Gustav2/P7/cw308t_mspm0l2228/render_top.png

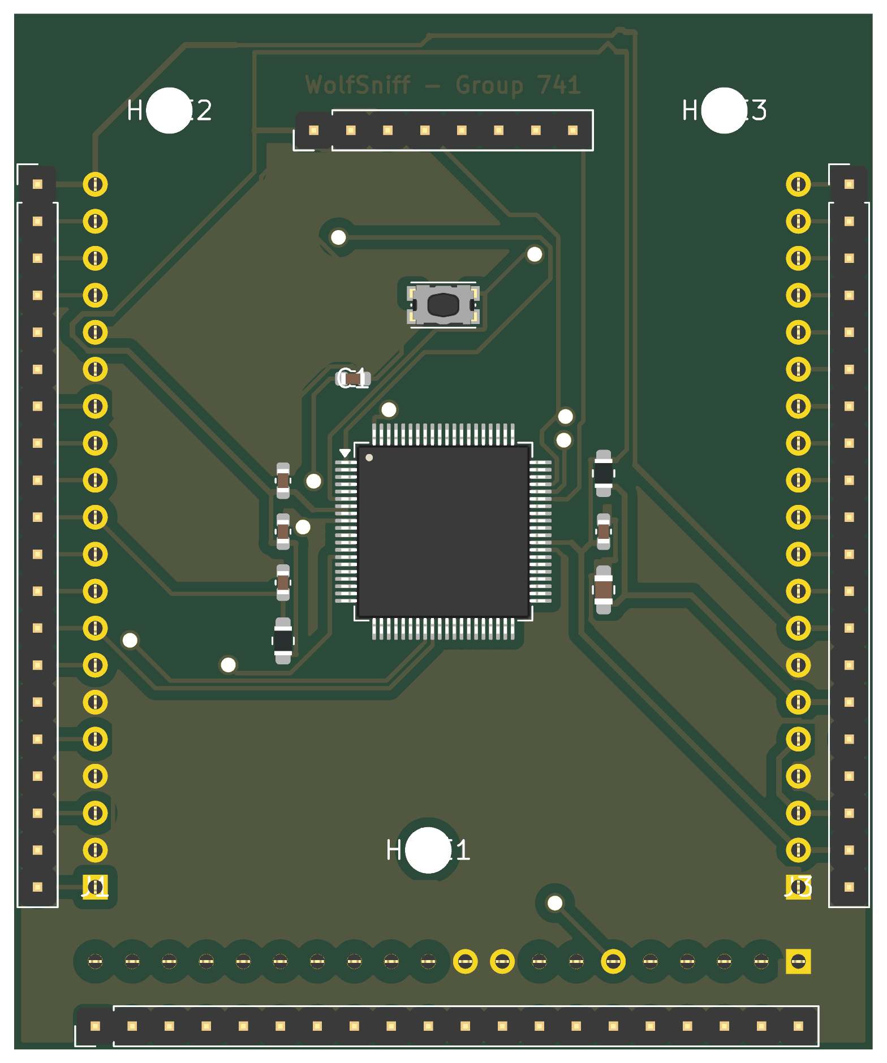
cw308t_mspm0l2228/render_top.png
