Gustav2/P7/cw308t_mspm0l2228/BOM.csv

Ref | Qty | Value | Footprint | Populate | Notes
U1 | 1 | MSPM0L2228SPN | LQFP-80 14x14 0.65mm | YES | Target MCU
C1 | 1 | 470nF | 0603 | YES | VCORE (pin 80) - required | hard against the pin
C2 | 1 | 100nF | 0603 | YES | VDD/VSS (pin 8/9)
C5 | 1 | 100nF | 0603 | YES | VBAT (pin 7)
C3 | 1 | 100nF | 0603 | YES | VDD2 (pin 49)
C4 | 1 | 4.7uF | 0805 | YES | Bulk (supply side of shunt)
C6 | 1 | 100nF | 0603 | NO (DNP) | Optional nRST cap
R1 | 1 | 0R | 0805 | NO (DNP) | Optional local shunt
R2 | 1 | 10k | 0805 | NO (DNP) | Optional nRST pull-up
J1/J3/J4 | 3 | PinSocket 1x20 2.54mm | female vertical (BOTTOM) | YES | CW308 West/East/South sockets - mate down onto adapter
P1/P3/P4 | 3 | PinHeader 1x20 2.54mm | male vertical (TOP) | YES | All-60 breakout headers (offset 0.1in) for cables
J_SWD | 1 | Cortex 2x5 1.27mm | PinHeader 2x05 | YES | SWD debug
SW1 | 1 | Reset | SW KMR2 SMD | YES | nRST button
TP_BSL | 1 | BSL | TestPoint 1.5mm | OPTIONAL | PA18 BSL test point
HOLE1-3 | 3 | M3 | 3.2mm | YES | Mounting (adapter positions)
