Gustav2/P7/cw308t_mspm0l2228/sch.pdf

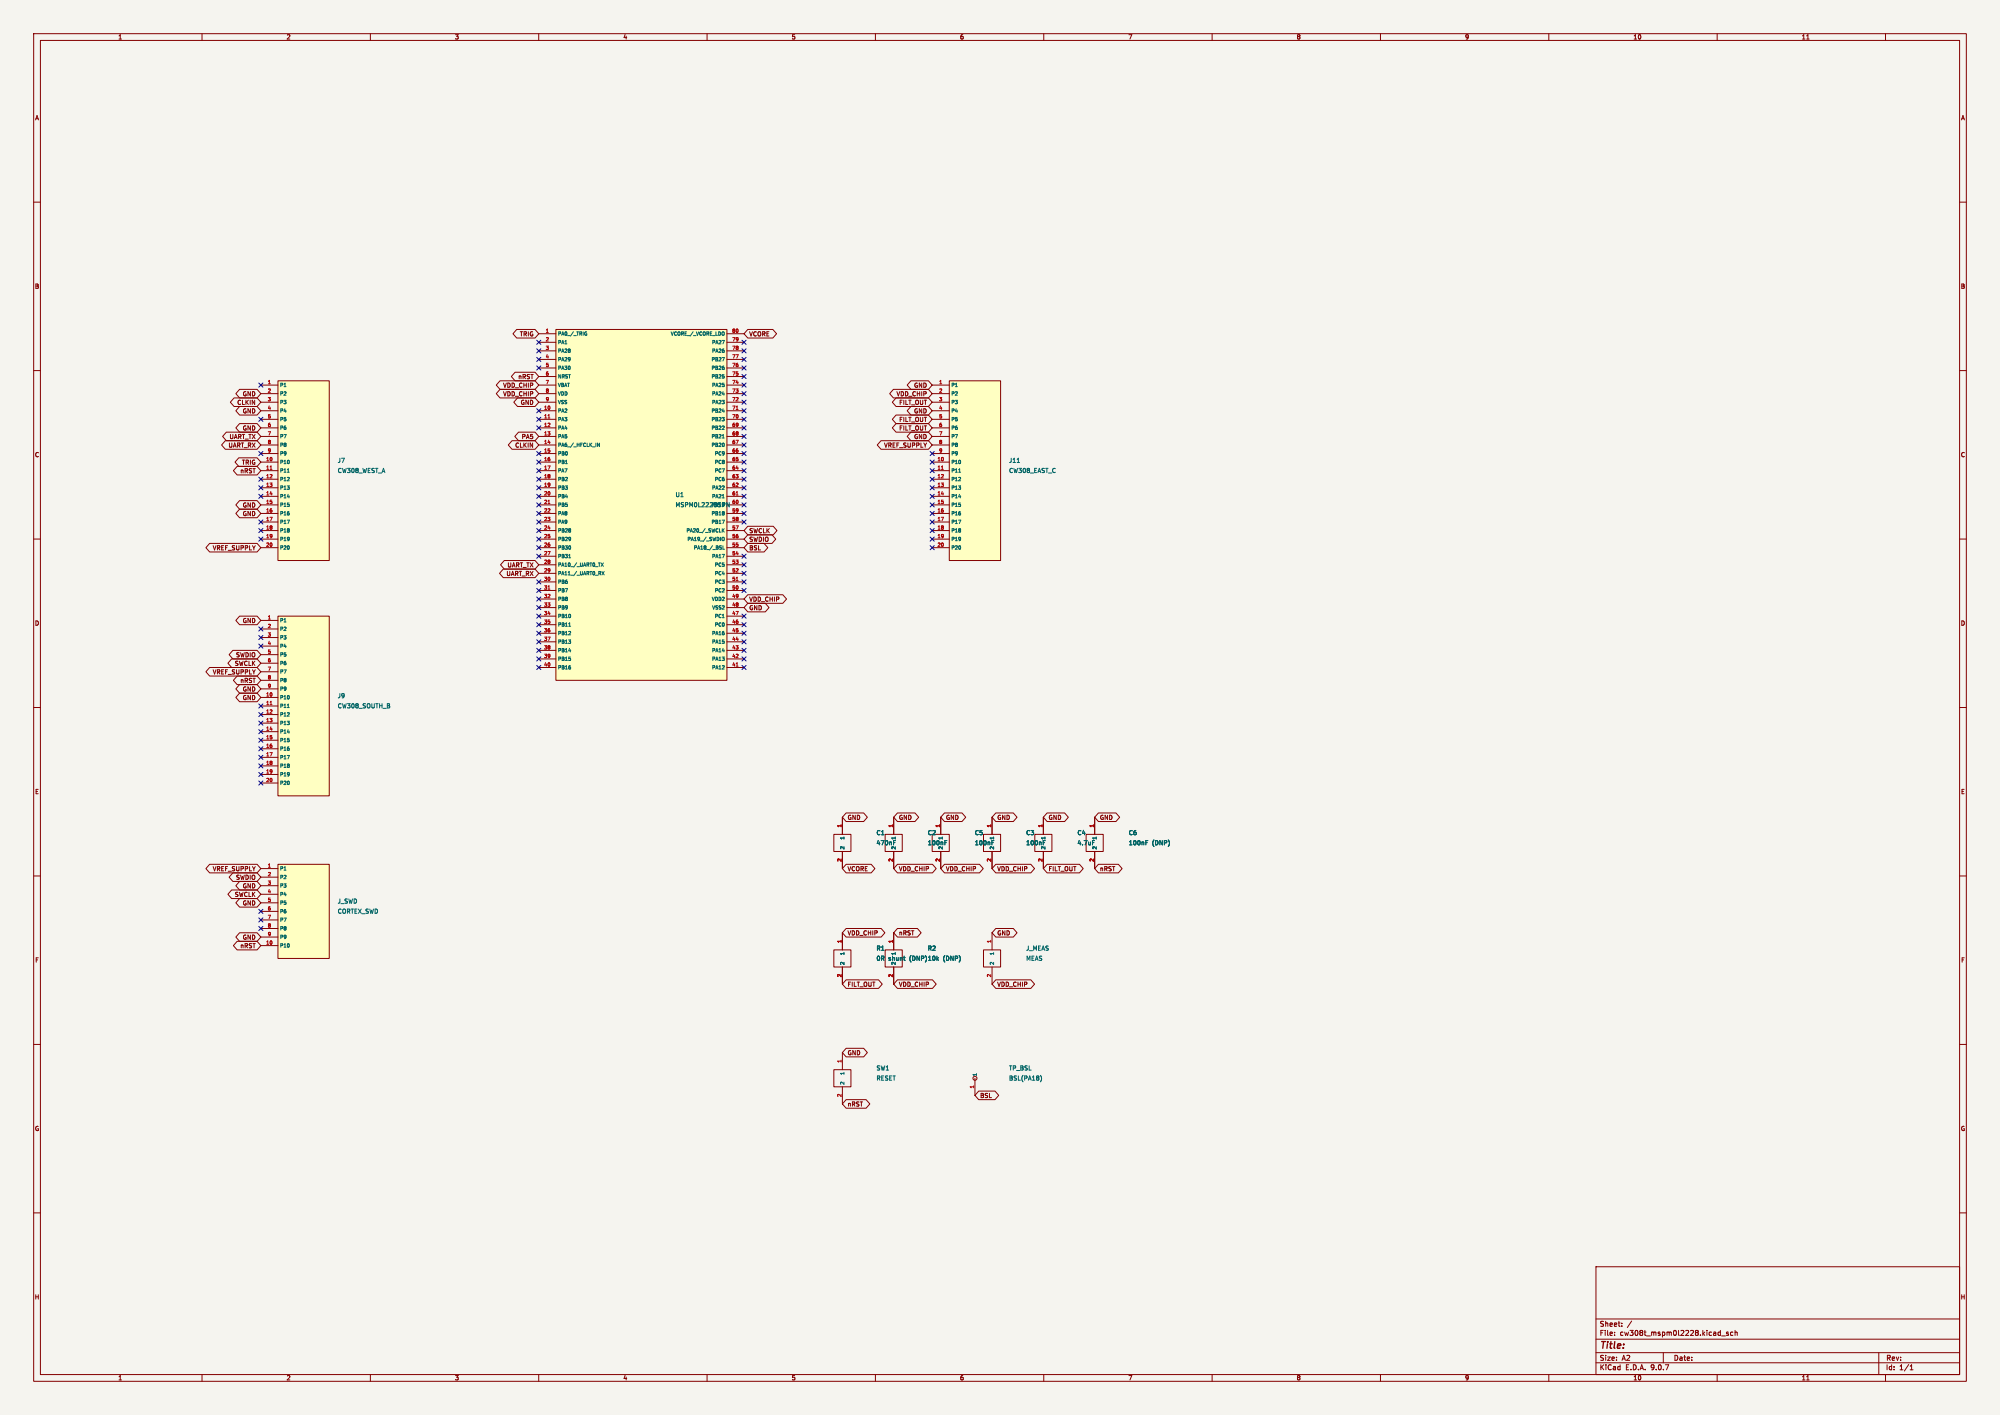
[picture p3: page 1]

CLKIN GND GND GND GND GND
nRST UART_RX UART_TX GND
