Gustav2/P7/cw308t_mspm0l2228/layout.pdf

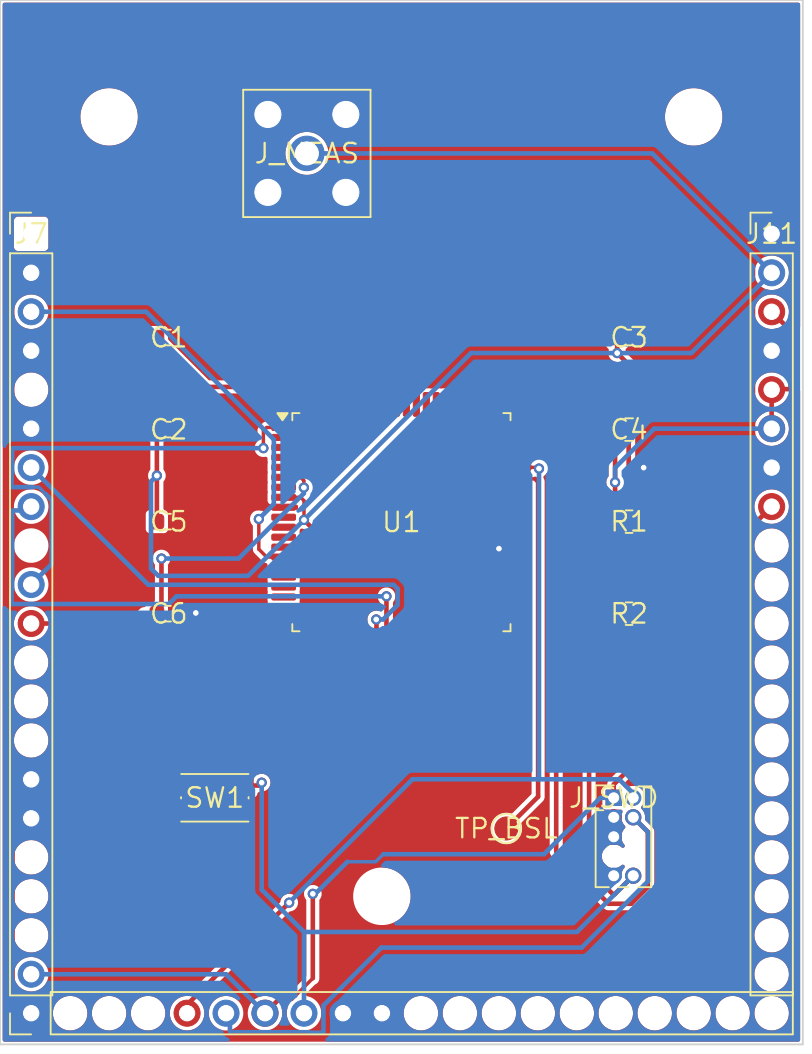
[picture p4: page 1]
