Gustav2/P7/(list of files, drawings)

Other design files:
cw308t_mspm0l2228/cw308t_mspm0l2228.dsn
