Gustav2/P7/pcb/pcb.kicad_pcb

## KiCad design pcb/pcb.kicad_pcb (2026-10-29)

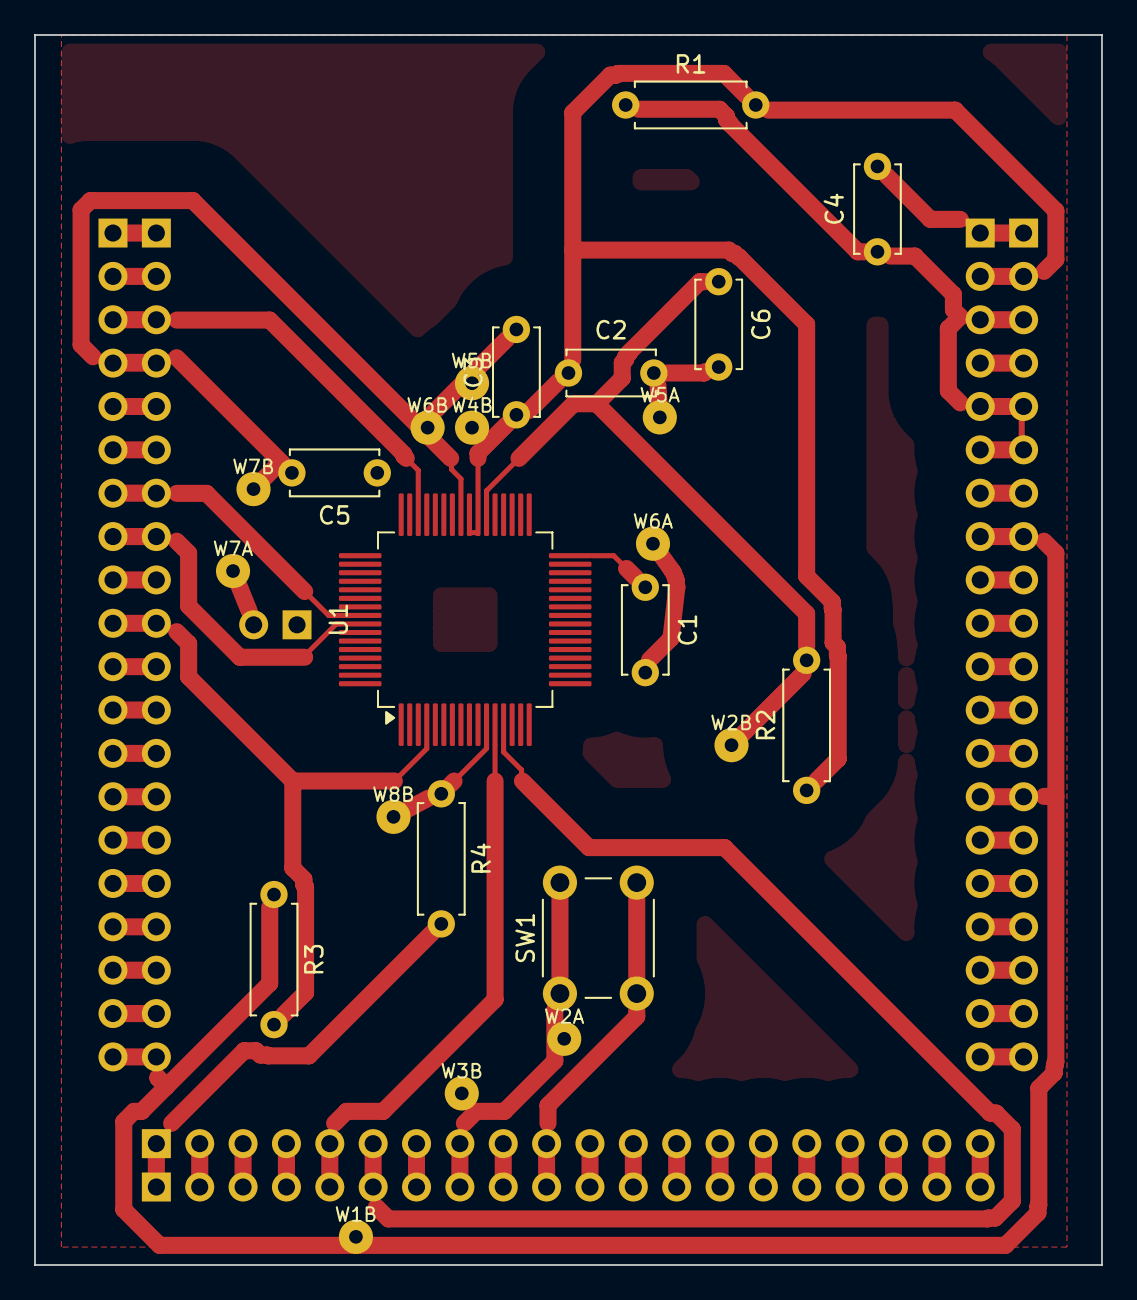
[picture p5: board pcb.kicad_pcb from above]

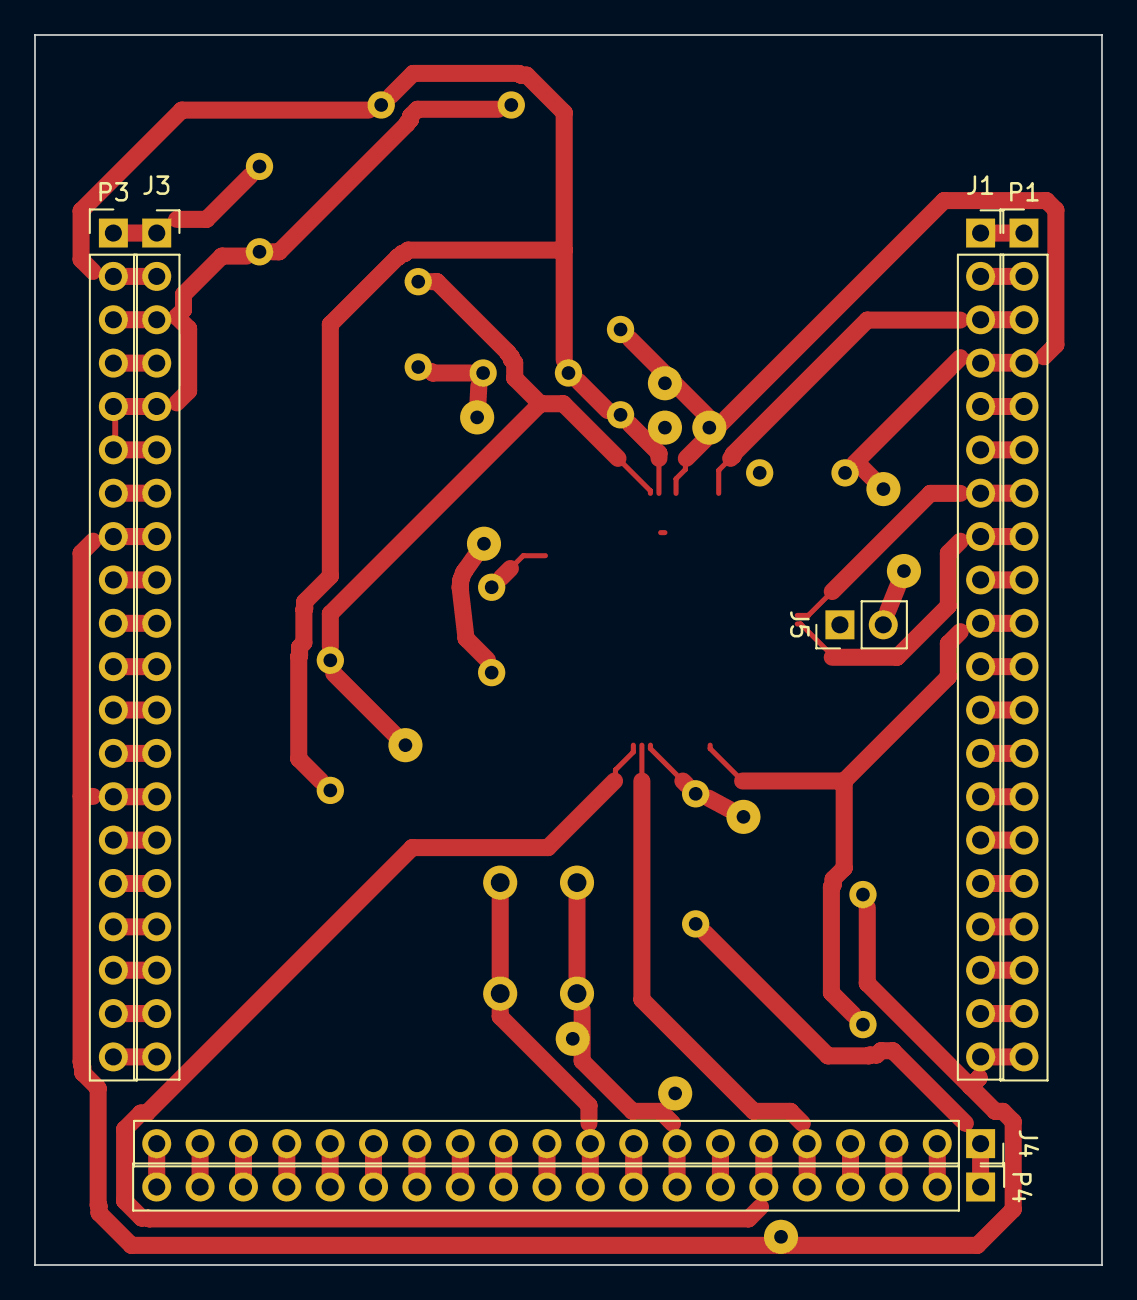
[picture p6: board pcb.kicad_pcb from below]

Board: 2 copper layers, 62.5 x 72.0 mm, 31 parts (7 on the bottom side), 42 nets.

Parts:
C1: 470nF; C_Disc_D5.0mm_W2.5mm_P5.00mm
C2: 10uF; C_Disc_D5.0mm_W2.5mm_P5.00mm
C3: 100nF; C_Disc_D5.0mm_W2.5mm_P5.00mm
C4: 4.7uF; C_Disc_D5.0mm_W2.5mm_P5.00mm
C5: 1uF; C_Disc_D5.0mm_W2.5mm_P5.00mm
C6: 10nF; C_Disc_D5.0mm_W2.5mm_P5.00mm
J1: CW308_WEST; PinSocket_1x20_P2.54mm_Vertical
J3: CW308_EAST; PinSocket_1x20_P2.54mm_Vertical
J4: CW308_SOUTH; PinSocket_1x20_P2.54mm_Vertical
J5: BSL_GND; PinHeader_1x02_P2.54mm_Vertical
P1: WEST_PINS; PinHeader_1x20_P2.54mm_Vertical
P3: EAST_PINS; PinHeader_1x20_P2.54mm_Vertical
P4: SOUTH_PINS; PinHeader_1x20_P2.54mm_Vertical
R1: 10R; R_Axial_DIN0207_L6.3mm_D2.5mm_P7.62mm_Horizontal
R2, R4: 47k; R_Axial_DIN0207_L6.3mm_D2.5mm_P7.62mm_Horizontal
R3: 4.7k; R_Axial_DIN0207_L6.3mm_D2.5mm_P7.62mm_Horizontal
SW1: RESET; SW_PUSH_6mm
U1: MSPM0L2228SPMR; LQFP-64_10x10mm_P0.5mm
W1B, W2A, W2B, W3B, W4B, W5A, W5B, W6A, W6B, W7A, W7B, W8B: Wire

Connections:
/TRIG: J1.10, P1.10, R3.2, U1.4 (PB16)
unnamed: J1.1, P1.1
unnamed: J1.3, P1.3, U1.46 (PA6)
unnamed: J1.5, P1.5
unnamed: J1.7, P1.7, U1.56 (PA10/BSL_TX)
unnamed: J1.8, P1.8, U1.57 (PA11/BSL_RX)
unnamed: J1.9, P1.9
unnamed: C6.1, J1.11, J4.8, P1.11, P4.8, R2.2, SW1.1, U1.38 (NRST), W2A.1, W2B.1, W3B.1
unnamed: J1.12, P1.12
unnamed: J1.13, P1.13
unnamed: J1.14, P1.14
unnamed: C1.2, C2.2, C3.2, C4.2, C5.2, C6.2, J1.2, J1.4, J1.6, J1.15, J1.16, J3.1, J3.4, J3.7, J3.9, J3.10, J3.16, J3.17, J4.1, J4.9, J4.10, J5.2, P1.2, P1.4, P1.6, P1.15, P1.16, P3.1, P3.4, P3.7, P3.9, P3.10, P3.16, P3.17, P4.1, P4.9, P4.10, R4.2, SW1.2, U1.41 (VSS), W5A.1, W5B.1, W6A.1, W6B.1, W7A.1, W7B.1
unnamed: J1.17, P1.17
unnamed: J1.18, P1.18
unnamed: J1.19, P1.19
unnamed: J1.20, J3.8, J3.14, J4.7, P1.20, P3.8, P3.14, P4.7, R3.1, W1B.1
unnamed: C2.1, C3.1, C5.1, J3.2, P3.2, R1.2, R2.1, U1.39 (VBAT), U1.40 (VDD), W4B.1
unnamed: C4.1, J3.3, J3.5, J3.6, P3.3, P3.5, P3.6, R1.1
unnamed: J3.11, P3.11
unnamed: J3.12, P3.12
unnamed: J3.13, P3.13
unnamed: J3.15, P3.15
unnamed: J3.18, P3.18
unnamed: J3.19, P3.19
unnamed: J3.20, P3.20
unnamed: J4.2, P4.2
unnamed: J4.3, P4.3
unnamed: J4.4, P4.4
unnamed: J4.5, P4.5, U1.12 (PA19/SWDIO)
unnamed: J4.6, P4.6, U1.13 (PA20/SWCLK)
unnamed: J4.11, P4.11
unnamed: J4.12, P4.12
unnamed: J4.13, P4.13
unnamed: J4.14, P4.14
unnamed: J4.15, P4.15
unnamed: J4.16, P4.16
unnamed: J4.17, P4.17
unnamed: J4.18, P4.18
unnamed: J4.19, P4.19
unnamed: J4.20, P4.20
unnamed: J5.1, R4.1, U1.11 (PA18/BSL_INVOKE), W8B.1
unnamed: C1.1, U1.32 (VCORE)
