Gustav2/P7/cw308t_mspm0l2228/cw308t_mspm0l2228.kicad_pcb

## KiCad design cw308t_mspm0l2228/cw308t_mspm0l2228.kicad_pcb (2026-10-22)

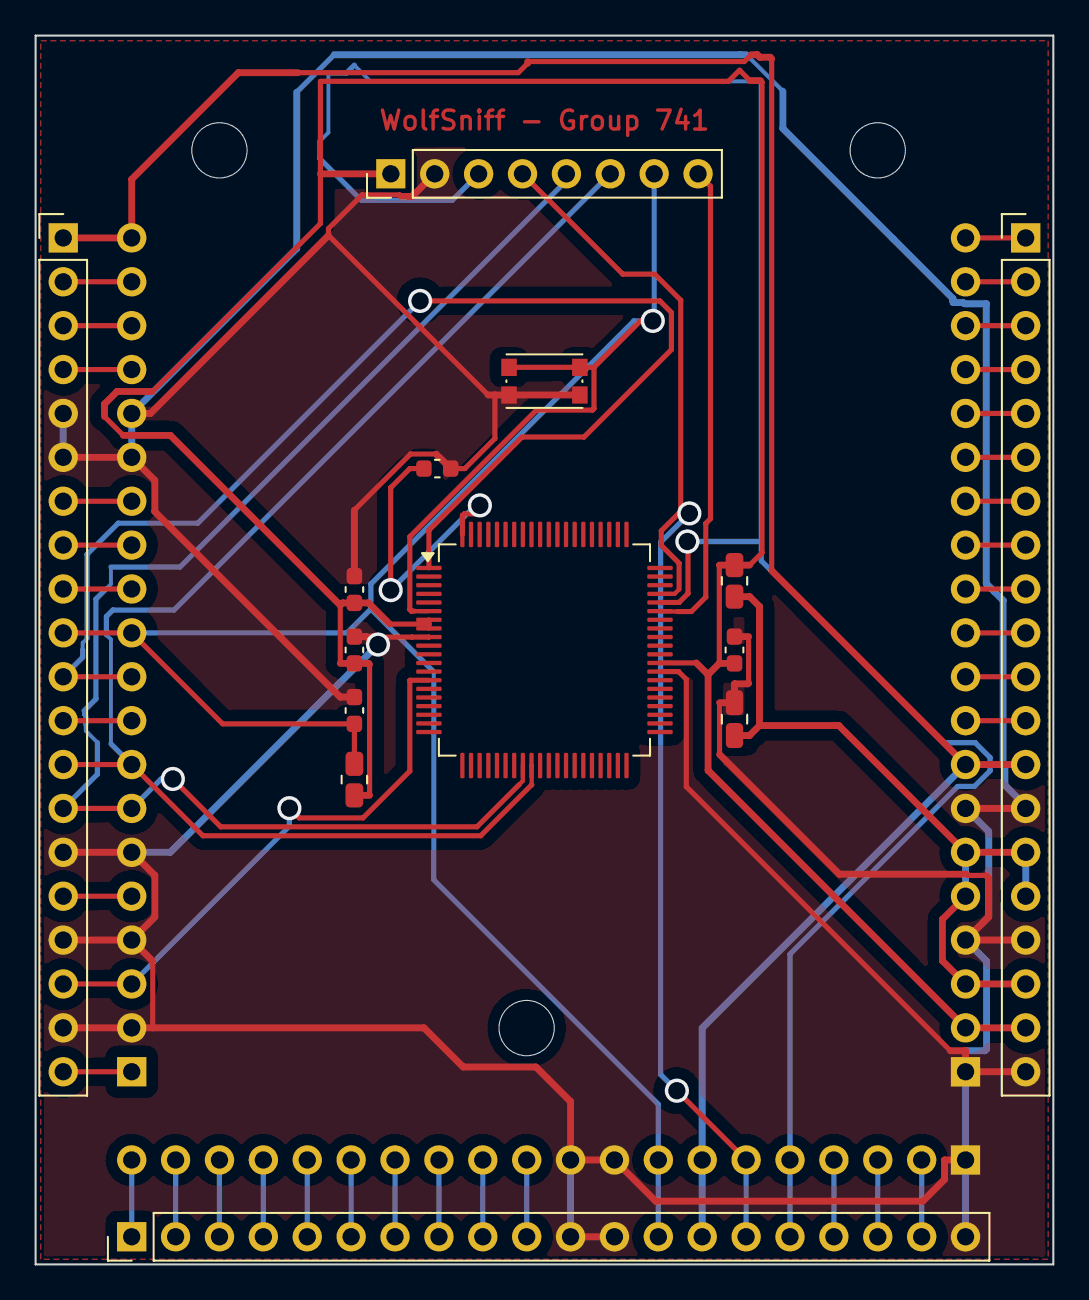
[picture p7: board cw308t_mspm0l2228.kicad_pcb from above]

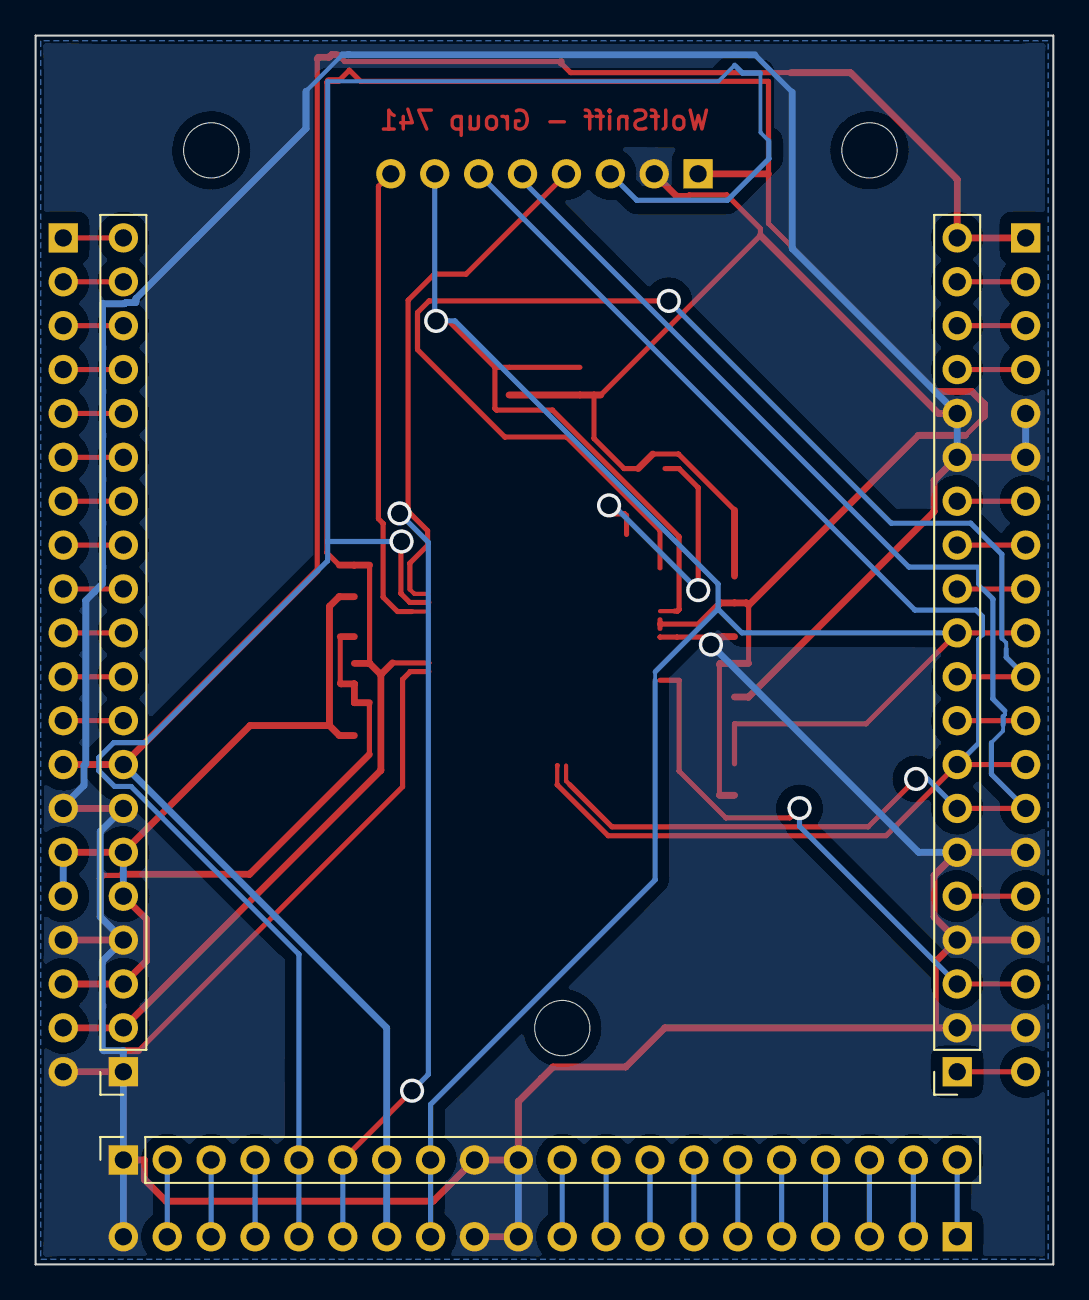
[picture p8: board cw308t_mspm0l2228.kicad_pcb from below]

Board: 2 copper layers, 58.9 x 71.1 mm, 20 parts (3 on the bottom side), 47 nets.

Parts:
C1: 470nF; C_0603_1608Metric
C2, C3, C5: 100nF; C_0603_1608Metric
C4: 4.7uF; C_0805_2012Metric
C6: 100nF_DNP; C_0603_1608Metric
HOLE1, HOLE2, HOLE3: M3; MountingHole_3.2mm_M3
J1: CW308_WEST_A; PinSocket_1x20_P2.54mm_Vertical
J3: CW308_EAST_C; PinSocket_1x20_P2.54mm_Vertical
J4: CW308_SOUTH_B; PinSocket_1x20_P2.54mm_Vertical
J_DBG: DEBUG; PinHeader_1x08_P2.54mm_Vertical
P1: WEST_BRK; PinHeader_1x20_P2.54mm_Vertical
P3: EAST_BRK; PinHeader_1x20_P2.54mm_Vertical
P4: SOUTH_BRK; PinHeader_1x20_P2.54mm_Vertical
R1: 0R_shunt_DNP; R_0805_2012Metric
R2: 10k_DNP; R_0805_2012Metric
SW1: RESET; SW_Push_1P1T_NO_CK_KMR2
U1: MSPM0L2228SPN; LQFP-80_12x12mm_P0.5mm

Connections:
BSL: J_DBG.8, U1.55
CLKIN: J1.3, P1.18, U1.14
FILT_OUT: C4.1, J3.3, J3.5, J3.6, P3.15, P3.16, P3.18, R1.1
GND: C1.2, C2.2, C3.2, C4.2, C5.2, C6.2, J1.2, J1.4, J1.6, J1.15, J1.16, J3.1, J3.4, J3.7, J4.1, J4.9, J4.10, J_DBG.2, P1.5, P1.6, P1.15, P1.17, P1.19, P3.14, P3.17, P3.20, P4.11, P4.12, P4.20, SW1.2, U1.9, U1.48
SP_E9: J3.9, P3.12
SP_E10: J3.10, P3.11
SP_E11: J3.11, P3.10
SP_E12: J3.12, P3.9
SP_E13: J3.13, P3.8
SP_E14: J3.14, P3.7
SP_E15: J3.15, P3.6
SP_E16: J3.16, P3.5
SP_E17: J3.17, P3.4
SP_E18: J3.18, P3.3
SP_E19: J3.19, P3.2
SP_E20: J3.20, P3.1
SP_S2: J4.2, P4.19
SP_S3: J4.3, P4.18
SP_S4: J4.4, P4.17
SP_S11: J4.11, P4.10
SP_S12: J4.12, P4.9
SP_S13: J4.13, P4.8
SP_S14: J4.14, P4.7
SP_S15: J4.15, P4.6
SP_S16: J4.16, P4.5
SP_S17: J4.17, P4.4
SP_S18: J4.18, P4.3
SP_S19: J4.19, P4.2
SP_S20: J4.20, P4.1
SP_W1: J1.1, P1.20
SP_W5: J1.5, P1.16
SP_W9: J1.9, P1.12
SP_W12: J1.12, P1.9
SP_W13: J1.13, P1.8
SP_W14: J1.14, P1.7
SP_W17: J1.17, P1.4
SP_W18: J1.18, P1.3
SP_W19: J1.19, P1.2
SWCLK: J4.6, J_DBG.4, P4.15, U1.57
SWDIO: J4.5, J_DBG.3, P4.16, U1.56
TRIG: J1.10, P1.11, U1.1
UART_RX: J1.8, J_DBG.6, P1.13, U1.29
UART_TX: J1.7, J_DBG.5, P1.14, U1.28
VCORE: C1.1, U1.80
VDD_CHIP: C2.1, C3.1, C5.1, J3.2, J_DBG.1, P3.19, R1.2, R2.1, U1.7, U1.8, U1.49
VREF_SUPPLY: J1.20, J3.8, J4.7, P1.1, P3.13, P4.14
nRST: C6.1, J1.11, J4.8, J_DBG.7, P1.10, P4.13, R2.2, SW1.1, U1.6
