Gustav2/P7/(commit log)

2026-10-07 Added board code
2026-10-22 Added pcb
2026-10-22 PCB: CNC-ready revision (pin-through vias, 8-pin debug header, label)
    - 1.0mm drilled pin-through vias (1.4mm pad), no vias under U1
    - 8-pin 2.54mm debug header: 3V3, GND, SWDIO, SWCLK, TXD, RXD, RST, BSL
    - Wider traces (0.4mm power / 0.3mm signal), 0.8mm pour isolation
    - "WolfSniff - Group 741" copper label
    - CNC export (cnc/ + cw308t_mspm0l2228_cnc.zip), regenerated gerbers
2026-10-22 PCB: correct MSPM0L2228 package, no traces under the chip
    - U1 footprint LQFP-80_14x14mm_P0.65mm -> LQFP-80_12x12mm_P0.5mm
    (TI PN0080A: 12x12 body, 14x14 over leads, 0.5mm pitch)
    - Routing keepout under the chip body on both layers (VDD/GND crossed it)
    - Re-routed: 0 unconnected, 0 clearance; 10 vias, none under U1
    - Power 0.4mm, necked to 0.3mm at the 0.25mm QFP pads
    - Regenerated CNC files, gerbers, renders; BOM/README/schematic updated
2026-10-22 Ignore KiCad lock files
2026-10-25 Added new pcb
2026-10-28 PCB: auto-place and single-sided route, wire-jumper holes
    Moved U1, the passives and SW1 (headers stay locked) and routed every
    net on F.Cu only, with no vias. The 8 connections a single layer cannot
    make get through-hole landing pads W1A..W8B (W2 lands on the J1-10 pin)
    for wire jumpers on the back side.
2026-10-29 PCB: CNC-milled THT redesign, 1.0/0.5 mm, 8 wire jumpers, 3 mm fill isolation
    Single-sided hat for the CW308-to-CW313 adapter, all copper on F.Cu, no vias.
    - Through-hole parts: axial resistors, disc caps, 6 mm tactile switch.
    - Milling rules (pcb.kicad_dru): 1.0 mm traces / 0.5 mm isolation; 0.3/0.2 mm only in the
    MSP fan-out area (MSP_FINE) and 0.35/0.2 mm between header pins (HDR_GAPS), 0.2 mm cutter.
    No-net copper fill keeps 3 mm from all copper, 1 mm minimum width, small islands removed.
    - MSP pads lengthened to 0.3 x 2.5 mm for hand soldering.
    - J5 reduced to 2 pins (BSL, GND); the debugger uses the P breakout headers.
    - Trigger moved from PA0 to PB16 (MSP pin 4): firmware must fo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
2026-11-12 recompiled with debug uart set to 0
